jitendraphand/agrobot/docs/img/blender_anim_frame.jpg

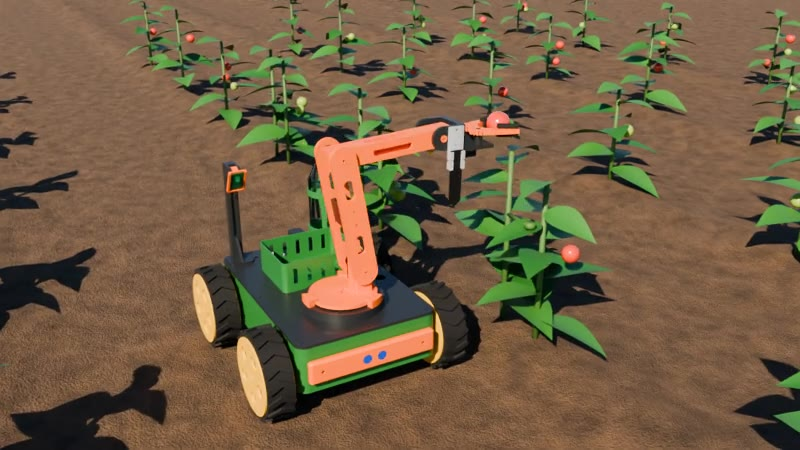
docs/img/blender_anim_frame.jpg
