jitendraphand/agrobot/simulation/assets/soil.png

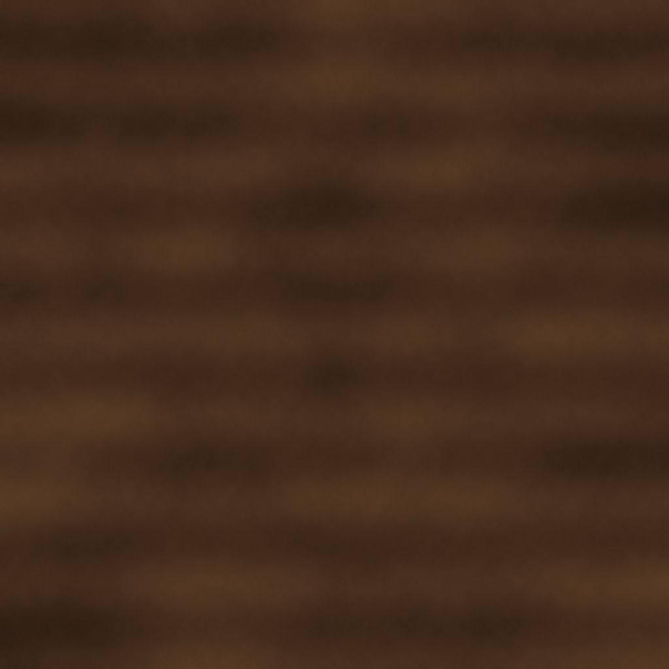
simulation/assets/soil.png
