jitendraphand/agrobot/cad/export/agrobot_assembly.step

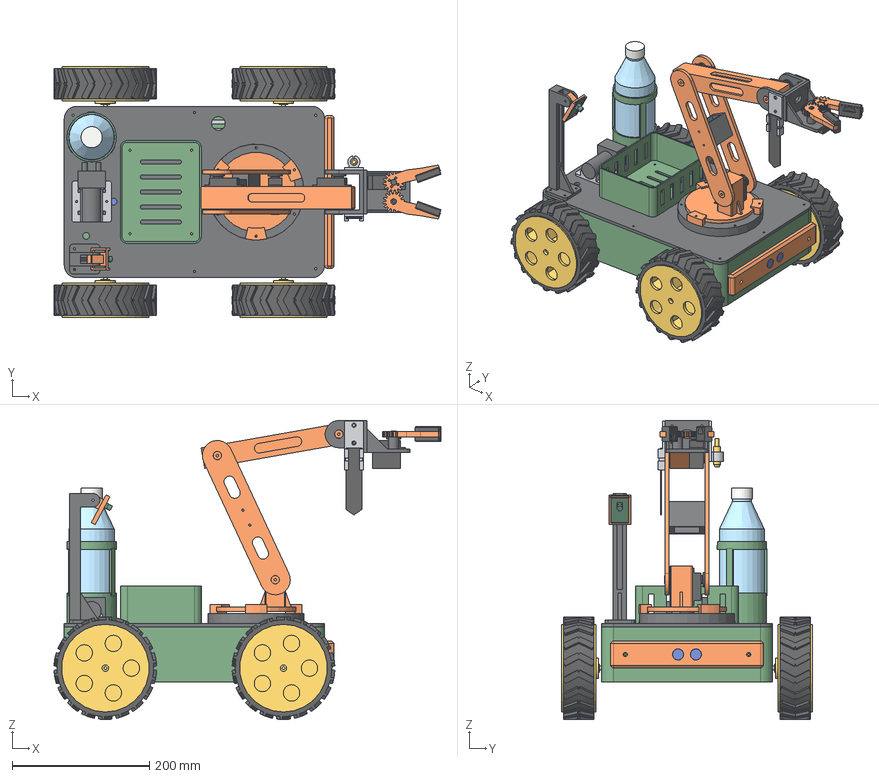
[picture p7: CAD file, 2026-11-11]
cad/export/agrobot_assembly.step
564.8 x 366.0 x 436.5 mm
chassis_tray
top_deck
electronics_plate
battery_clamp
front_bumper
wheel_rim_1 x 4
wheel_tyre_1 x 4
race_ring
turntable_clip_1 x 3
turntable
upper_arm_drive_plate
upper_arm_idler_plate
upper_arm_brace
forearm
wrist_fork
gripper_palm
finger_drive
finger_idle
finger_pad_1 x 2
probe_clip
nozzle_clip
harvest_basket
camera_mast
camera_holder
bottle_holder
pump_saddle
servo_std_1 x 5
gearmotor_1 x 4
hex_coupler_1 x 4
battery_3s
bottle_500ml
bottle_cap
pump_r385
hcsr04
esp32cam
soil_probe
spray_nozzle
esp32_devkit
pca9685
bts7960_left
bts7960_right
buck_5v_lm2596
buck_servo_xl4016
mosfet_pump
mpu6050
fuse_holder
