jitendraphand/agrobot/cad/export/step/gripper_palm.step

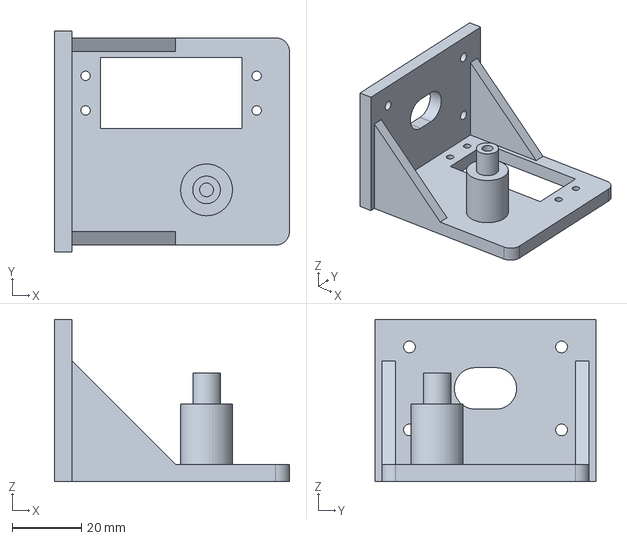
[picture p8: CAD file, 2026-11-11]
cad/export/step/gripper_palm.step
68.0 x 64.0 x 47.0 mm
