jitendraphand/agrobot/cad/export/vitamins/soil_probe.stl

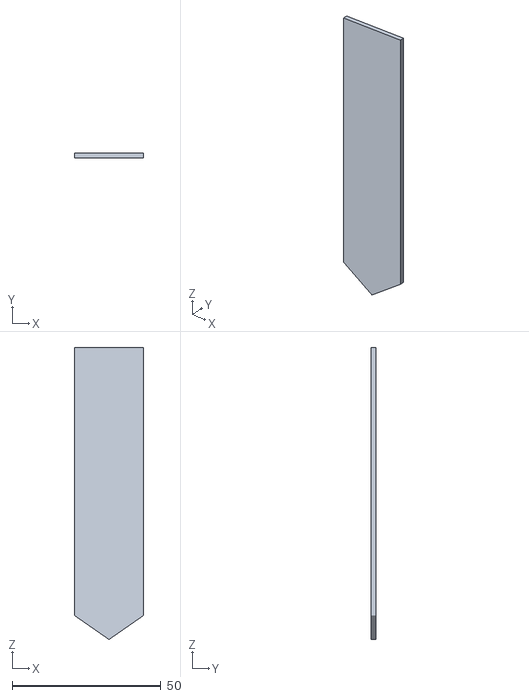
[picture p9: CAD file, 2026-11-11]
cad/export/vitamins/soil_probe.stl
23.0 x 1.60 x 98.0
