jitendraphand/agrobot/cad/export/step/camera_holder.step

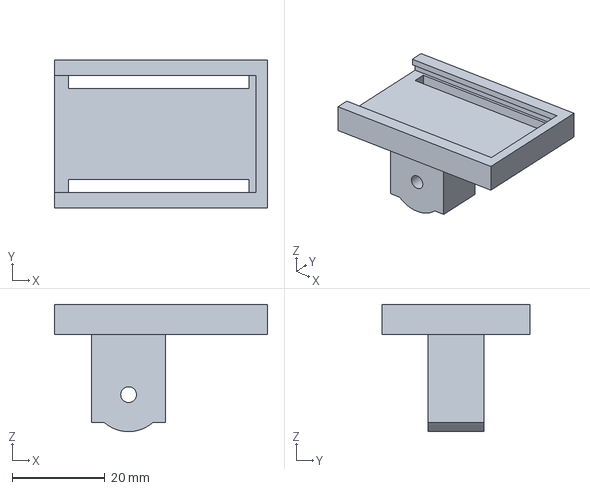
[picture p10: CAD file, 2026-11-11]
cad/export/step/camera_holder.step
46.0 x 32.0 x 27.5 mm
