jitendraphand/agrobot/cad/export/vitamins/mosfet_pump.stl

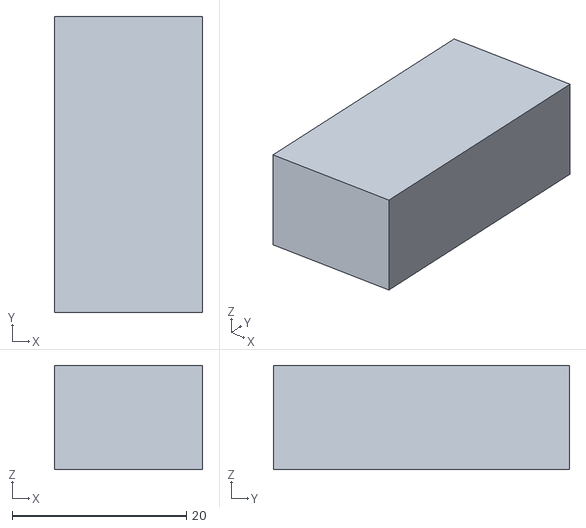
[picture p11: CAD file, 2026-11-11]
cad/export/vitamins/mosfet_pump.stl
17.0 x 34.0 x 12.0
