jitendraphand/agrobot/cad/export/step/harvest_basket.step

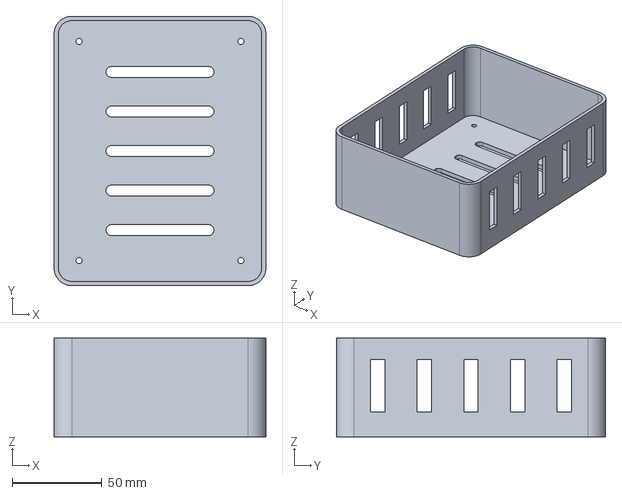
[picture p12: CAD file, 2026-11-11]
cad/export/step/harvest_basket.step
118.0 x 150.0 x 55.0 mm
