jitendraphand/agrobot/cad/export/vitamins/buck_servo_xl4016.stl

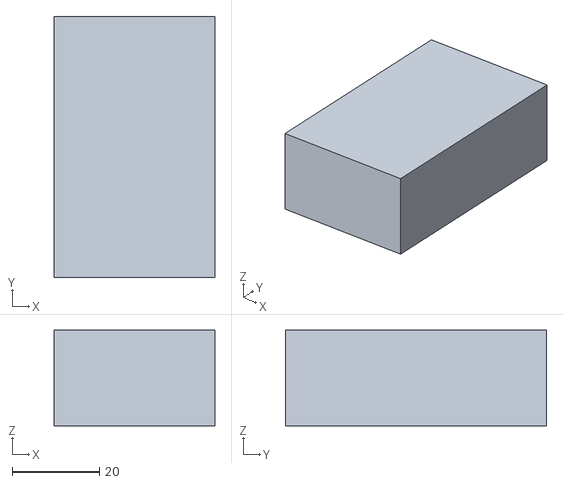
[picture p13: CAD file, 2026-11-11]
cad/export/vitamins/buck_servo_xl4016.stl
37.0 x 60.0 x 22.0
