jitendraphand/agrobot/cad/export/step/wrist_fork.step

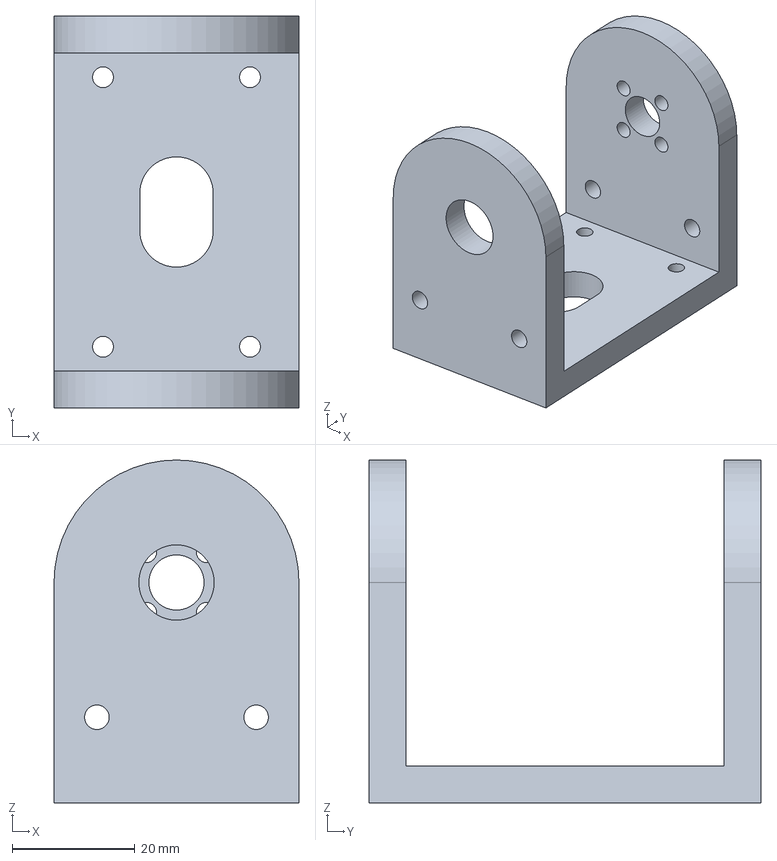
[picture p14: CAD file, 2026-11-11]
cad/export/step/wrist_fork.step
40.0 x 64.0 x 56.0 mm
