jitendraphand/agrobot/cad/export/vitamins/bts7960_left.stl

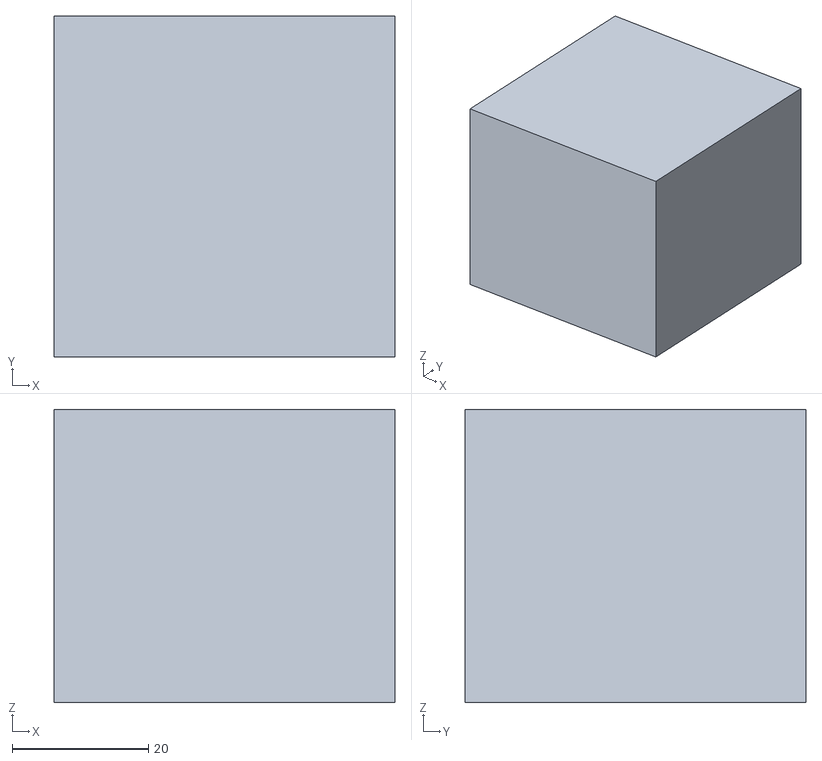
[picture p15: CAD file, 2026-11-11]
cad/export/vitamins/bts7960_left.stl
50.0 x 50.0 x 43.0
