jitendraphand/agrobot/cad/export/step/pump_saddle.step

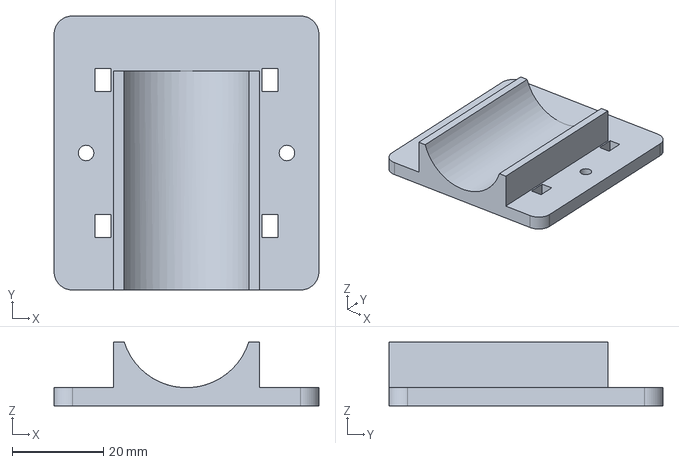
[picture p16: CAD file, 2026-11-11]
cad/export/step/pump_saddle.step
58.0 x 60.0 x 14.0 mm
