jitendraphand/agrobot/cad/export/vitamins/bottle_500ml.stl

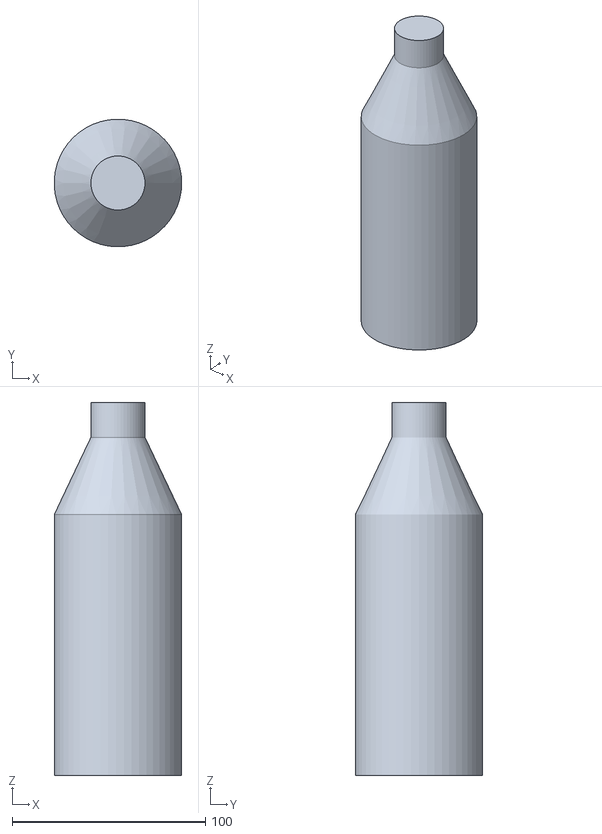
[picture p17: CAD file, 2026-11-11]
cad/export/vitamins/bottle_500ml.stl
65.9 x 66.0 x 193.0
