jitendraphand/agrobot/cad/export/step/camera_mast.step

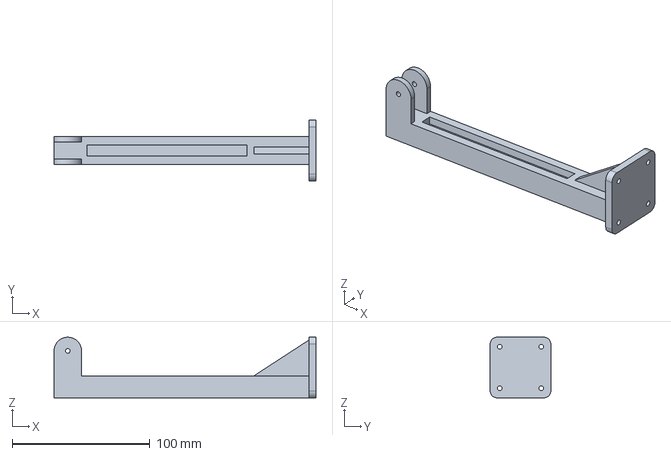
[picture p18: CAD file, 2026-11-11]
cad/export/step/camera_mast.step
190.0 x 44.0 x 44.0 mm
