jitendraphand/agrobot/cad/export/vitamins/esp32_devkit.stl

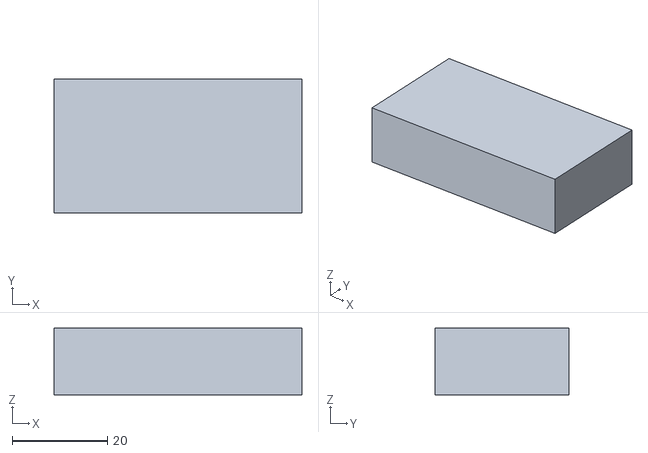
[picture p19: CAD file, 2026-11-11]
cad/export/vitamins/esp32_devkit.stl
52.0 x 28.0 x 14.0
