jitendraphand/agrobot/cad/export/step/forearm.step

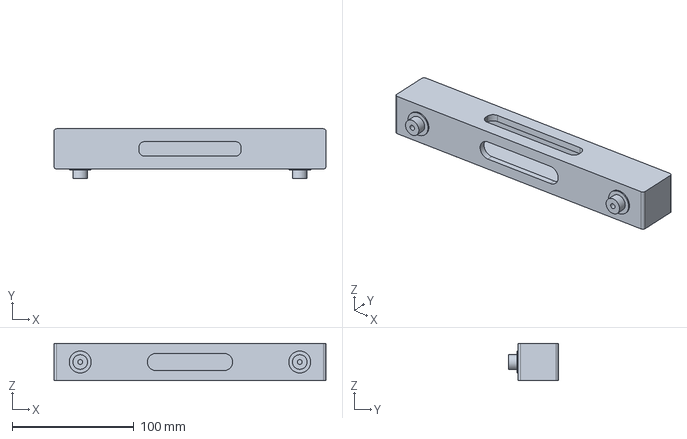
[picture p20: CAD file, 2026-11-11]
cad/export/step/forearm.step
223.0 x 40.6 x 30.4 mm
