jitendraphand/agrobot/cad/export/vitamins/pca9685.stl

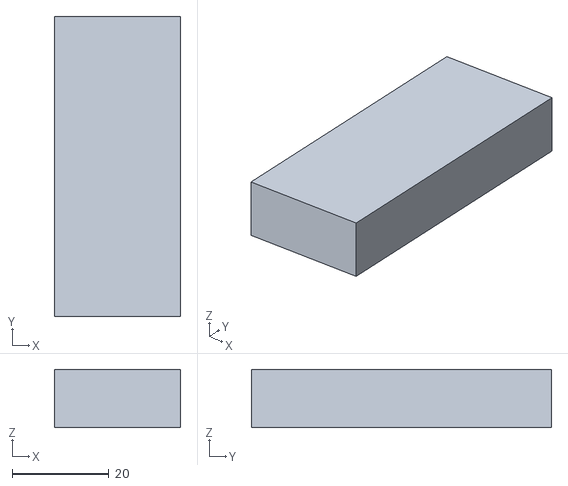
[picture p21: CAD file, 2026-11-11]
cad/export/vitamins/pca9685.stl
26.0 x 62.0 x 12.0
