jitendraphand/agrobot/cad/export/step/chassis_tray.step

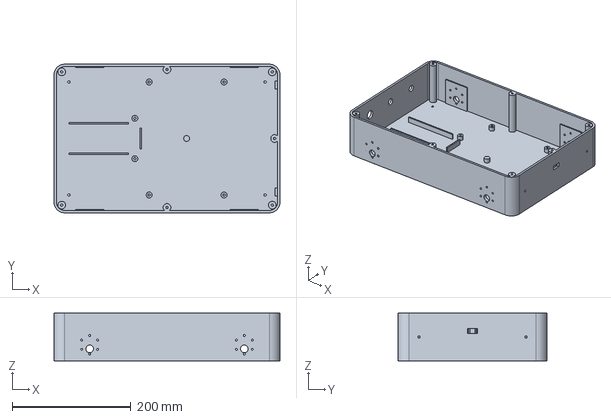
[picture p22: CAD file, 2026-11-11]
cad/export/step/chassis_tray.step
380.0 x 250.0 x 80.0 mm
