jitendraphand/agrobot/cad/export/vitamins/bottle_cap.stl

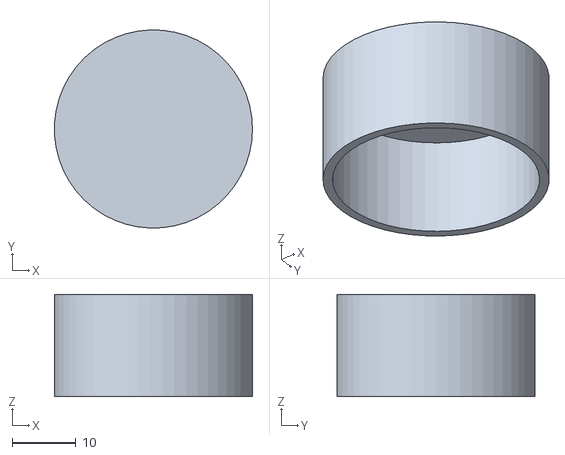
[picture p23: CAD file, 2026-11-11]
cad/export/vitamins/bottle_cap.stl
31.0 x 31.0 x 16.0
