jitendraphand/agrobot/cad/export/step/finger_drive.step

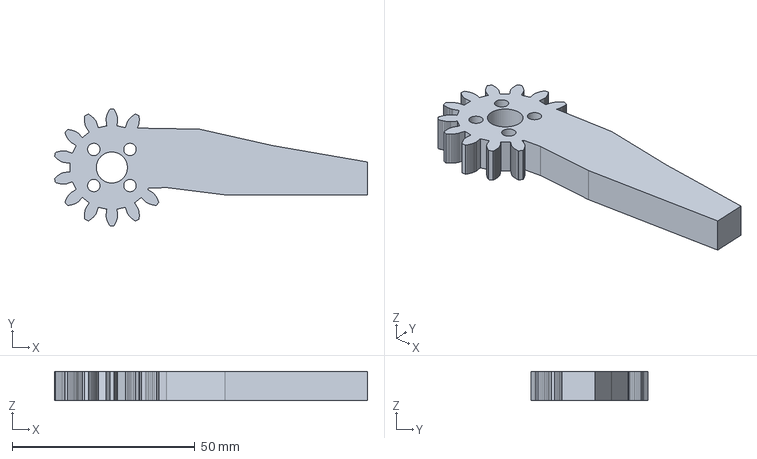
[picture p24: CAD file, 2026-11-11]
cad/export/step/finger_drive.step
85.7 x 32.0 x 8.00 mm
