jitendraphand/agrobot/cad/export/vitamins/race_balls.stl

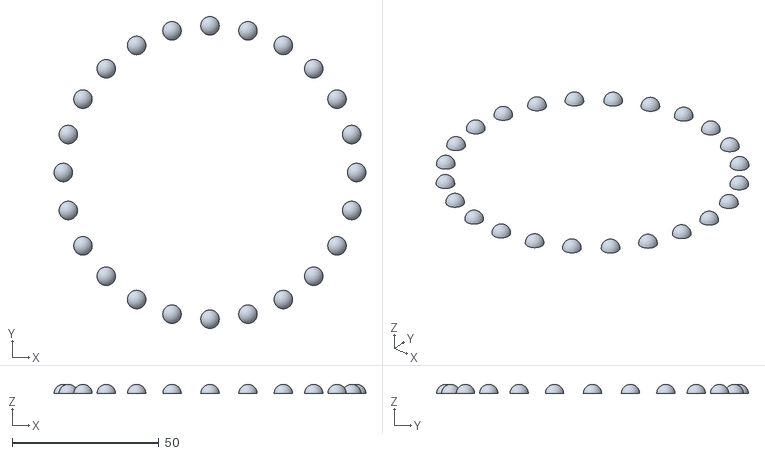
[picture p25: CAD file, 2026-11-11]
cad/export/vitamins/race_balls.stl
106.3 x 106.3 x 3.17
