jitendraphand/agrobot/cad/export/step/nozzle_clip.step

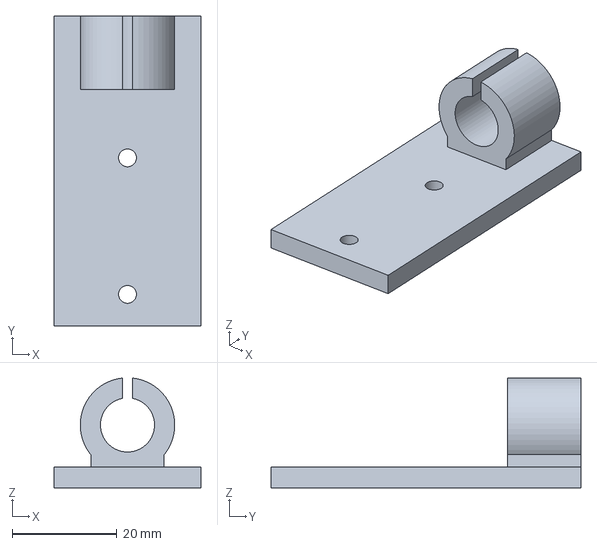
[picture p26: CAD file, 2026-11-11]
cad/export/step/nozzle_clip.step
28.0 x 59.0 x 20.9 mm
