jitendraphand/agrobot/cad/export/vitamins/gearmotor.stl

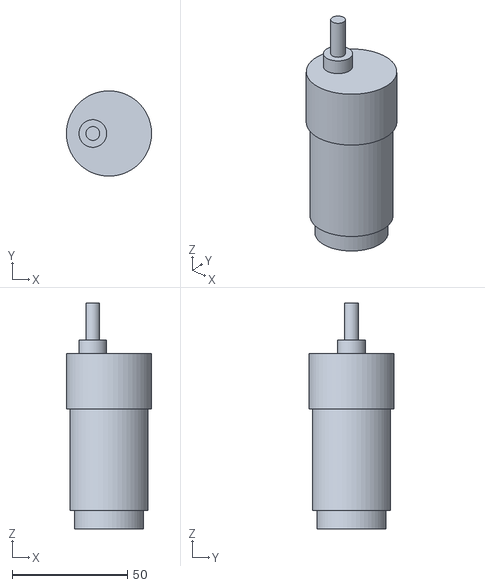
[picture p27: CAD file, 2026-11-11]
cad/export/vitamins/gearmotor.stl
37.0 x 37.0 x 98.0
