jitendraphand/agrobot/cad/export/step/upper_arm_idler_plate.step

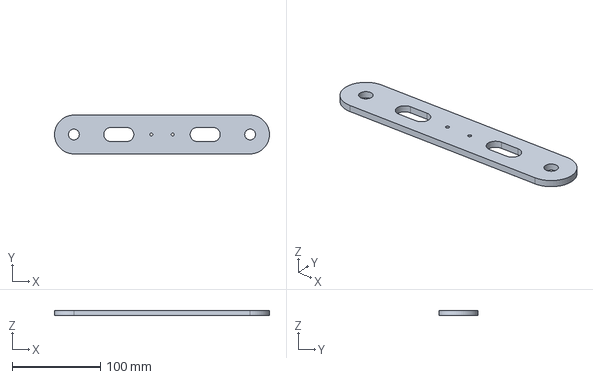
[picture p28: CAD file, 2026-11-11]
cad/export/step/upper_arm_idler_plate.step
244.0 x 44.0 x 6.00 mm
