jitendraphand/agrobot/cad/export/vitamins/hex_coupler.stl

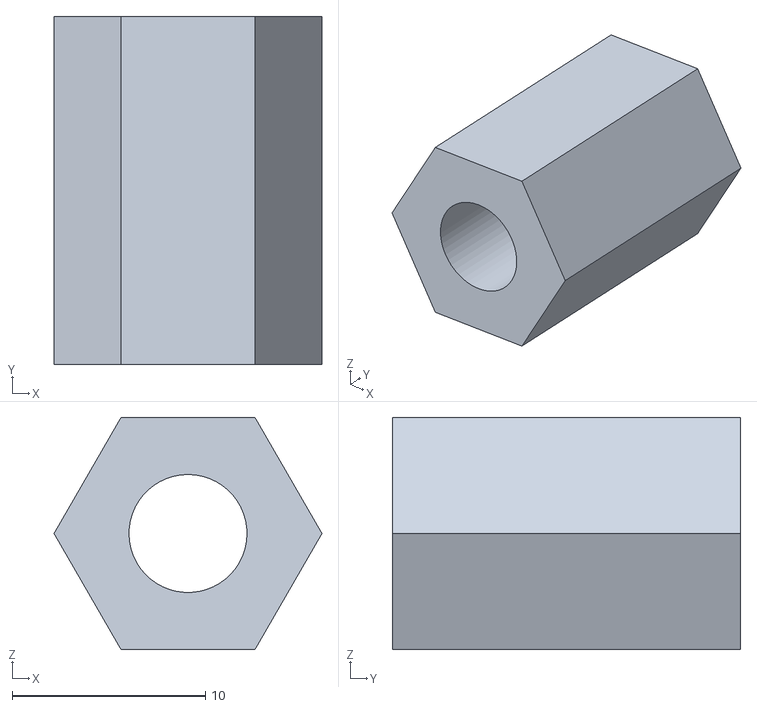
[picture p29: CAD file, 2026-11-11]
cad/export/vitamins/hex_coupler.stl
13.9 x 18.0 x 12.0
