jitendraphand/agrobot/cad/export/step/front_bumper.step

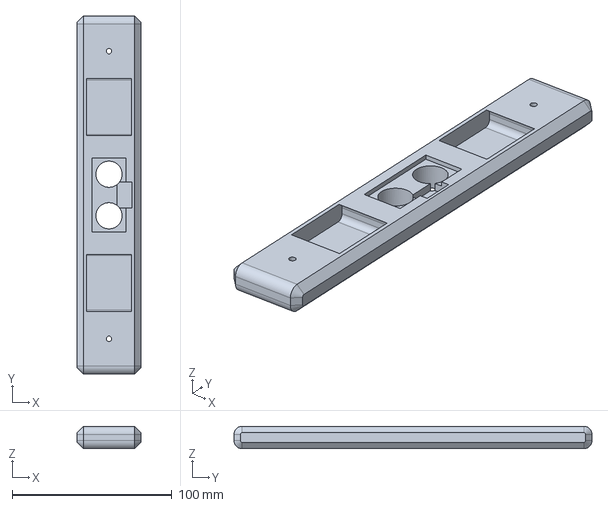
[picture p30: CAD file, 2026-11-11]
cad/export/step/front_bumper.step
40.0 x 224.0 x 14.0 mm
