jitendraphand/agrobot/cad/export/vitamins/battery_3s.stl

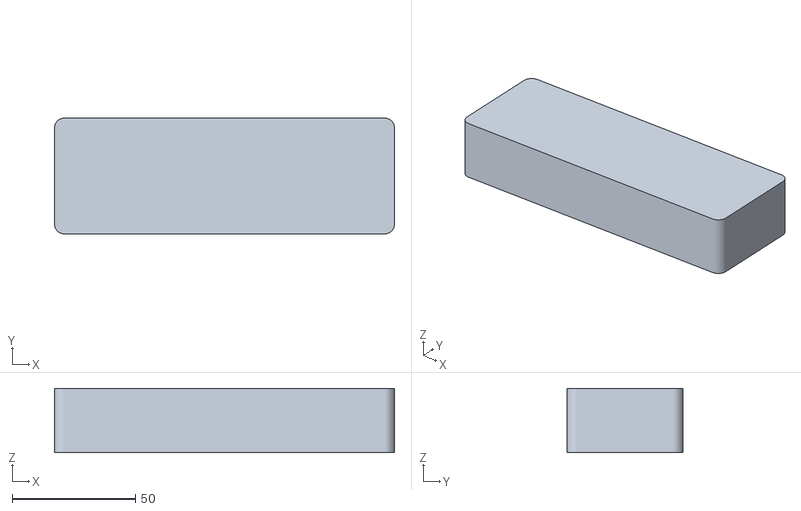
[picture p31: CAD file, 2026-11-11]
cad/export/vitamins/battery_3s.stl
138.0 x 47.0 x 26.0
