jitendraphand/agrobot/cad/export/step/wheel_rim.step

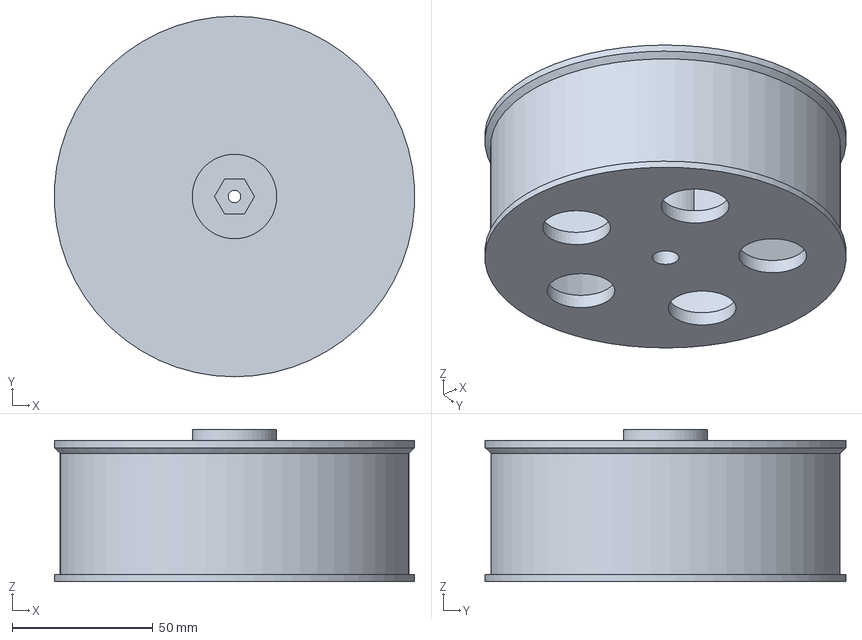
[picture p32: CAD file, 2026-11-11]
cad/export/step/wheel_rim.step
127.8 x 128.0 x 54.0 mm
