jitendraphand/agrobot/cad/export/vitamins/esp32cam.stl

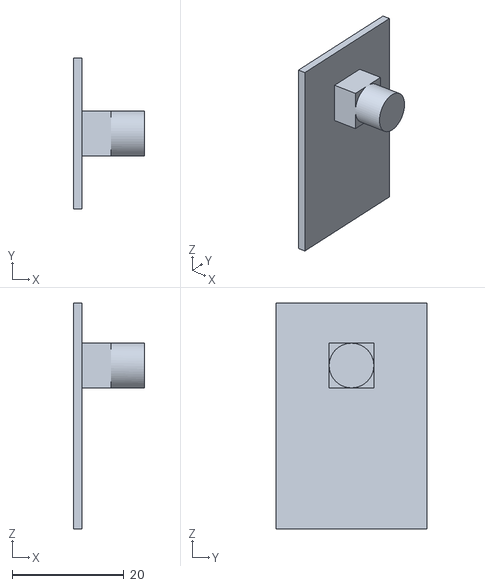
[picture p33: CAD file, 2026-11-11]
cad/export/vitamins/esp32cam.stl
12.8 x 27.0 x 40.5
