jitendraphand/agrobot/cad/export/step/finger_pad.step

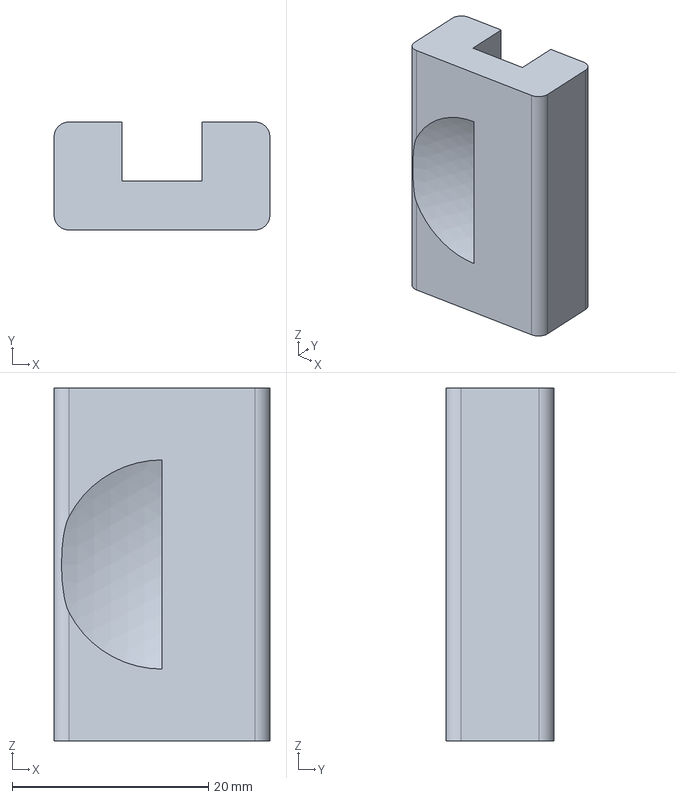
[picture p34: CAD file, 2026-11-11]
cad/export/step/finger_pad.step
22.0 x 11.0 x 36.0 mm
