jitendraphand/agrobot/cad/export/step/finger_idle.step

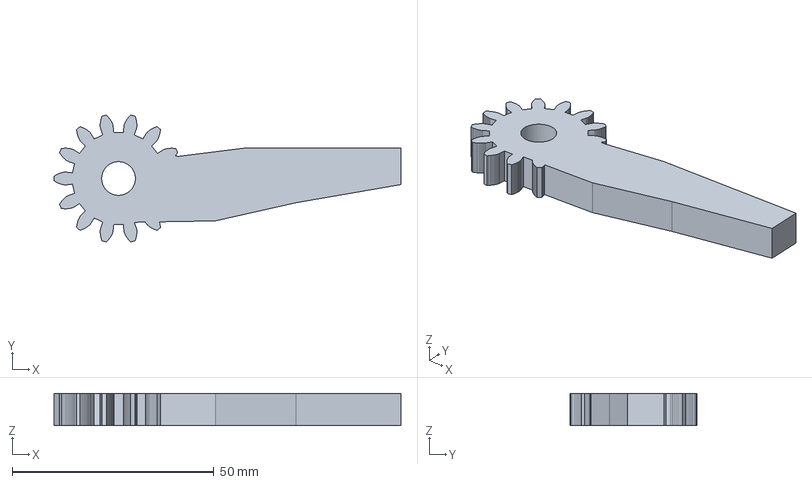
[picture p35: CAD file, 2026-11-11]
cad/export/step/finger_idle.step
86.0 x 31.4 x 8.00 mm
