jitendraphand/agrobot/cad/export/vitamins/mpu6050.stl

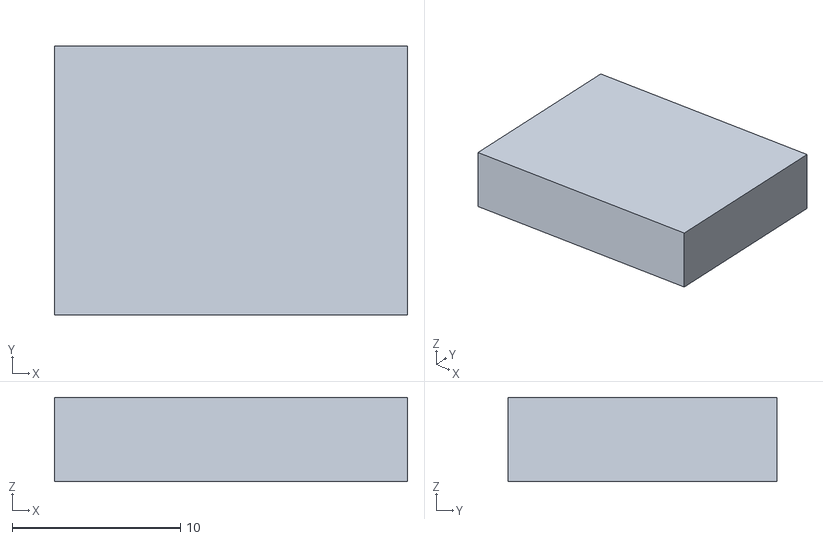
[picture p36: CAD file, 2026-11-11]
cad/export/vitamins/mpu6050.stl
21.0 x 16.0 x 5.00
