jitendraphand/agrobot/cad/export/step/probe_clip.step

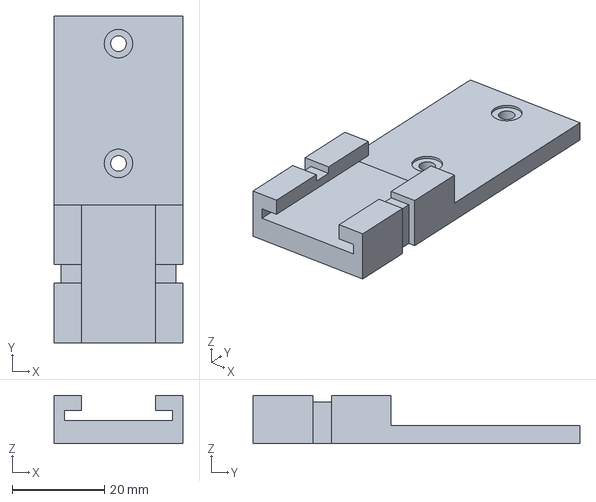
[picture p37: CAD file, 2026-11-11]
cad/export/step/probe_clip.step
28.0 x 71.0 x 10.5 mm
