jitendraphand/agrobot/cad/export/vitamins/spray_nozzle.stl

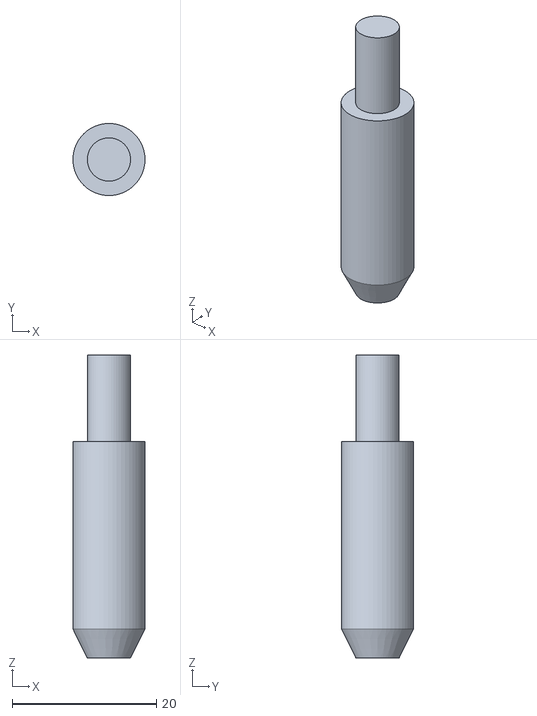
[picture p38: CAD file, 2026-11-11]
cad/export/vitamins/spray_nozzle.stl
9.99 x 10.00 x 42.0
