jitendraphand/agrobot/cad/export/vitamins/fuse_holder.stl

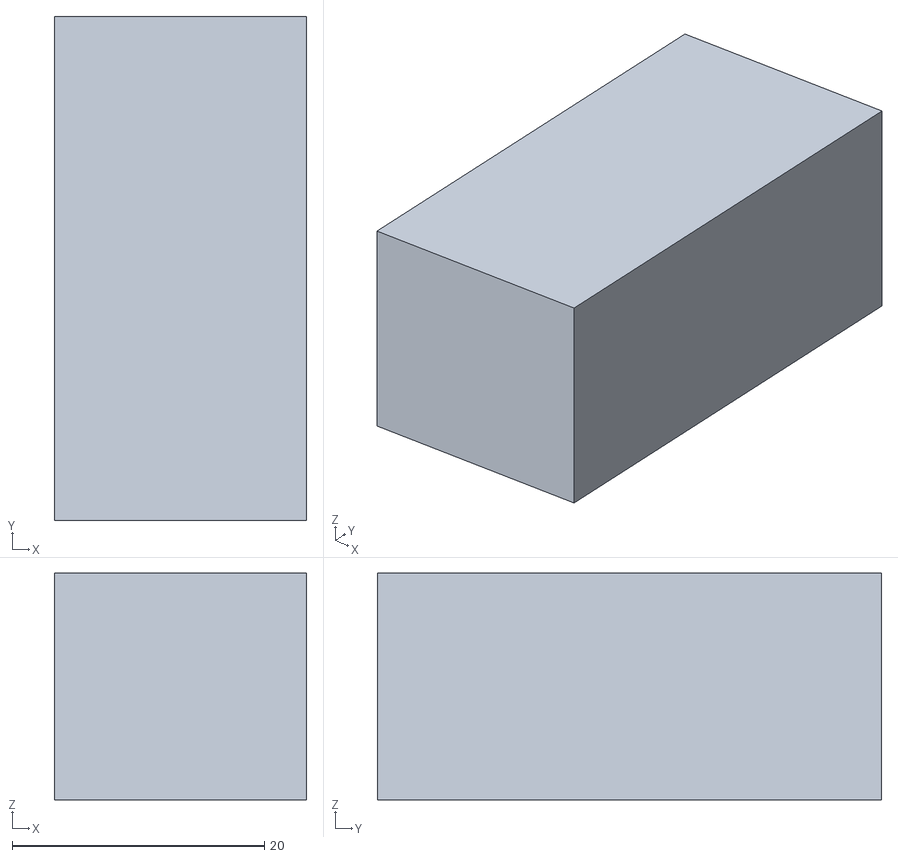
[picture p39: CAD file, 2026-11-11]
cad/export/vitamins/fuse_holder.stl
20.0 x 40.0 x 18.0
