jitendraphand/agrobot/cad/export/step/race_ring.step

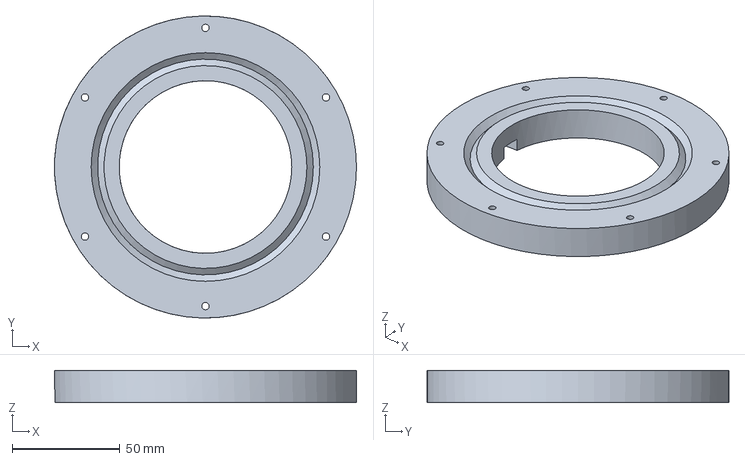
[picture p40: CAD file, 2026-11-11]
cad/export/step/race_ring.step
140.0 x 140.0 x 15.0 mm
