jitendraphand/agrobot/cad/export/vitamins/hcsr04.stl

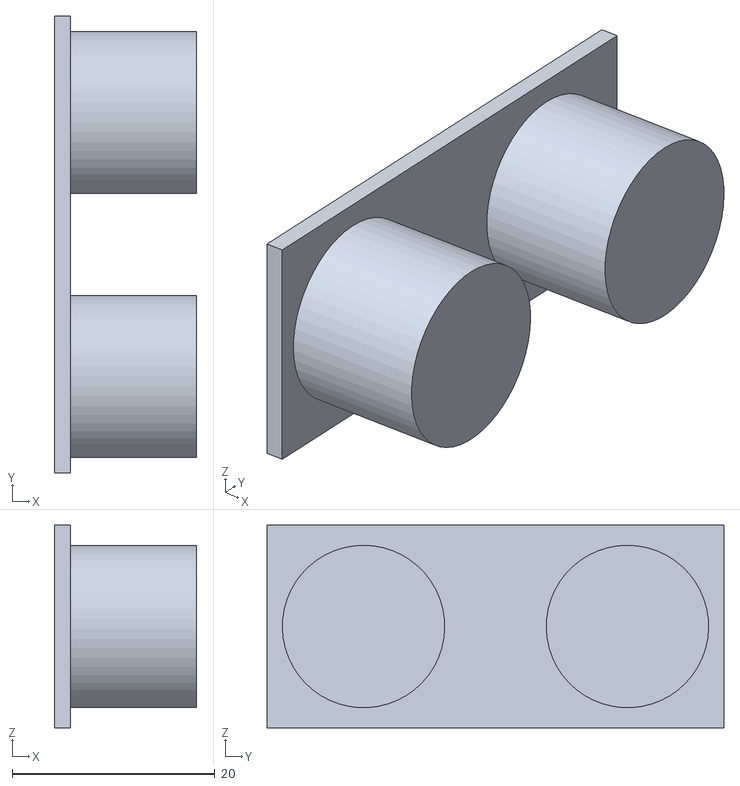
[picture p41: CAD file, 2026-11-11]
cad/export/vitamins/hcsr04.stl
14.0 x 45.0 x 20.0
