jitendraphand/agrobot/cad/export/step/battery_clamp.step

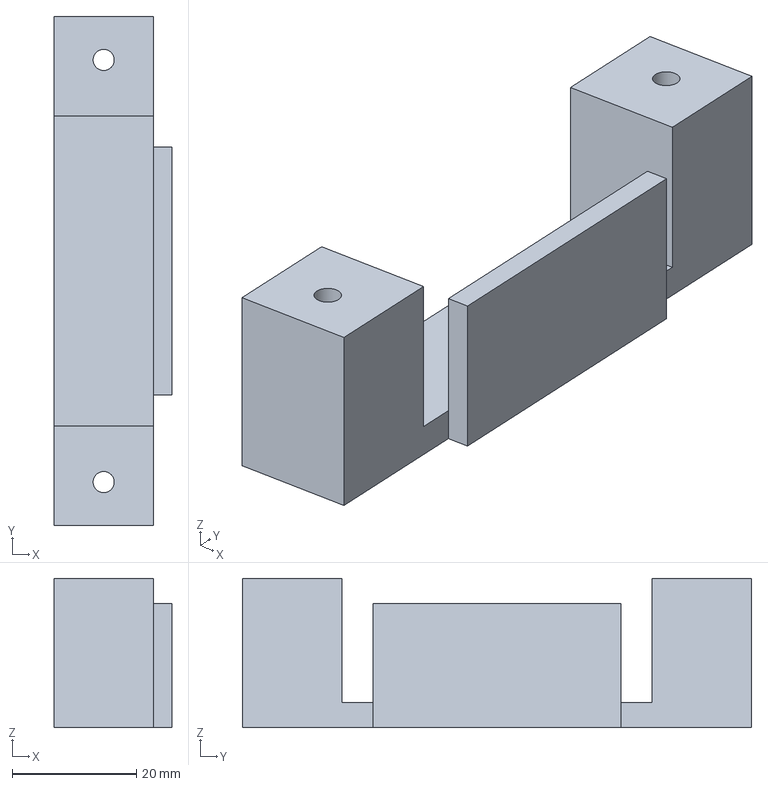
[picture p42: CAD file, 2026-11-11]
cad/export/step/battery_clamp.step
19.0 x 82.0 x 24.0 mm
