jitendraphand/agrobot/cad/export/vitamins/servo_std.stl

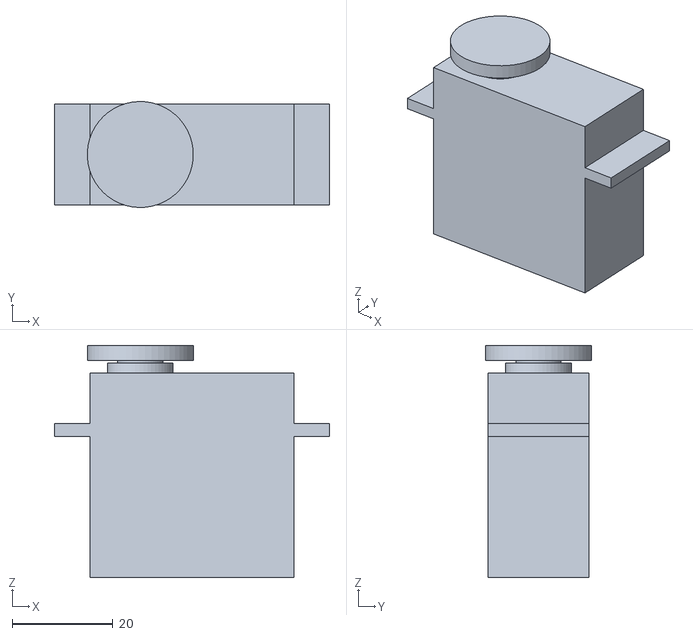
[picture p43: CAD file, 2026-11-11]
cad/export/vitamins/servo_std.stl
54.5 x 21.0 x 46.0
