jitendraphand/agrobot/cad/export/step/electronics_plate.step

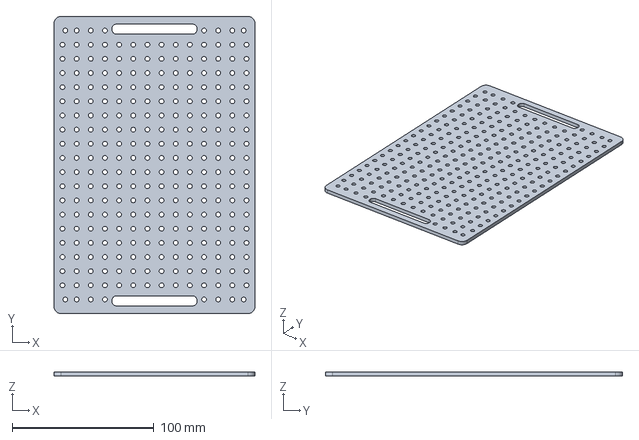
[picture p44: CAD file, 2026-11-11]
cad/export/step/electronics_plate.step
142.0 x 210.0 x 3.00 mm
