jitendraphand/agrobot/cad/export/vitamins/pump_r385.stl

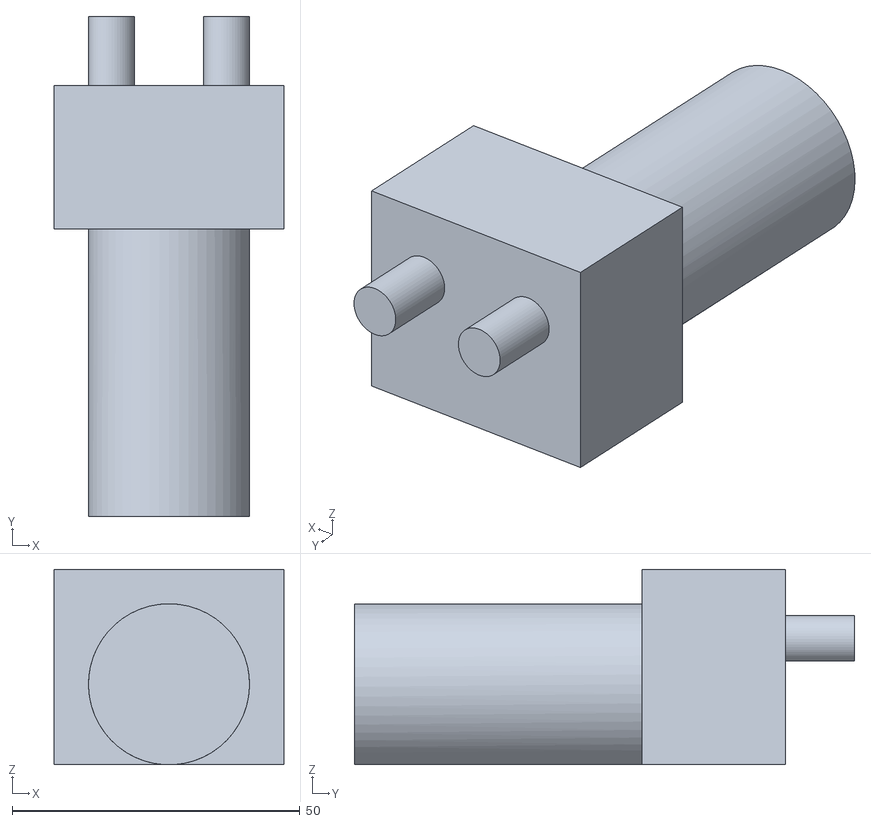
[picture p45: CAD file, 2026-11-11]
cad/export/vitamins/pump_r385.stl
40.0 x 87.0 x 34.0
