jitendraphand/agrobot/cad/export/step/turntable.step

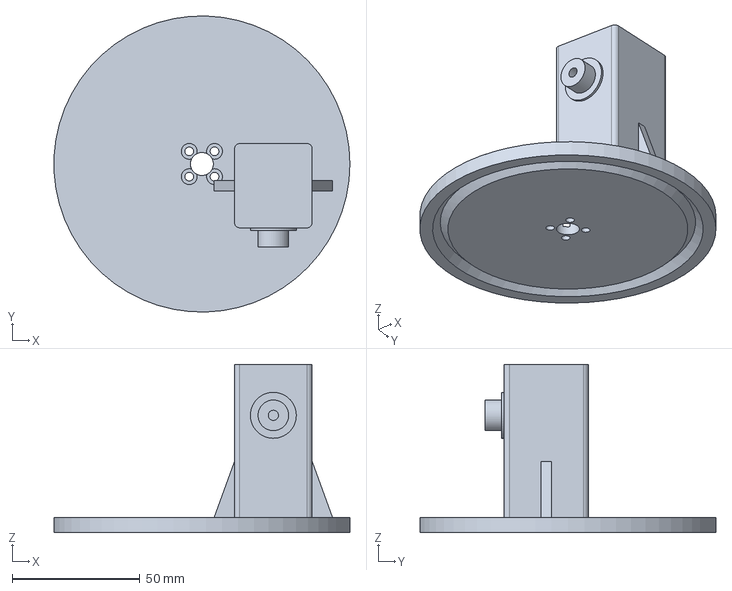
[picture p46: CAD file, 2026-11-11]
cad/export/step/turntable.step
115.9 x 116.0 x 66.0 mm
