jitendraphand/agrobot/cad/export/vitamins/buck_5v_lm2596.stl

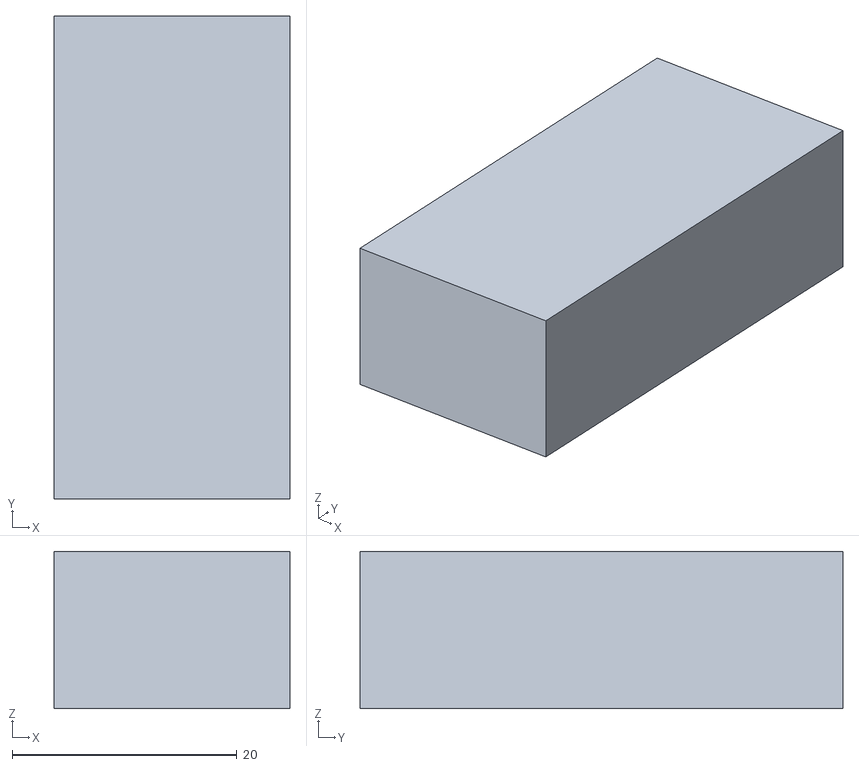
[picture p47: CAD file, 2026-11-11]
cad/export/vitamins/buck_5v_lm2596.stl
21.0 x 43.0 x 14.0
