jitendraphand/agrobot/cad/export/step/wheel_tyre.step

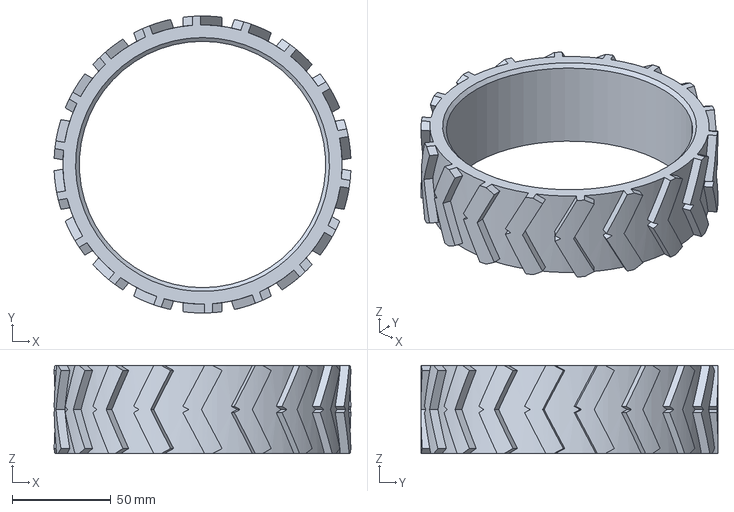
[picture p48: CAD file, 2026-11-11]
cad/export/step/wheel_tyre.step
149.9 x 150.0 x 44.6 mm
