jitendraphand/agrobot/cad/export/step/upper_arm_brace.step

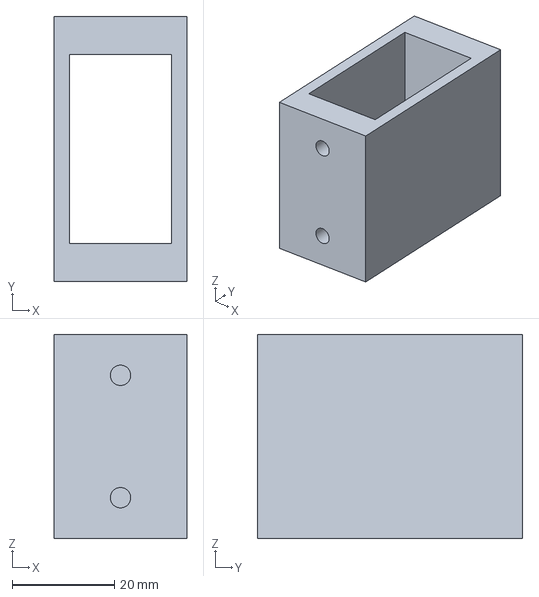
[picture p49: CAD file, 2026-11-11]
cad/export/step/upper_arm_brace.step
26.0 x 52.0 x 40.0 mm
