jitendraphand/agrobot/cad/export/step/bottle_holder.step

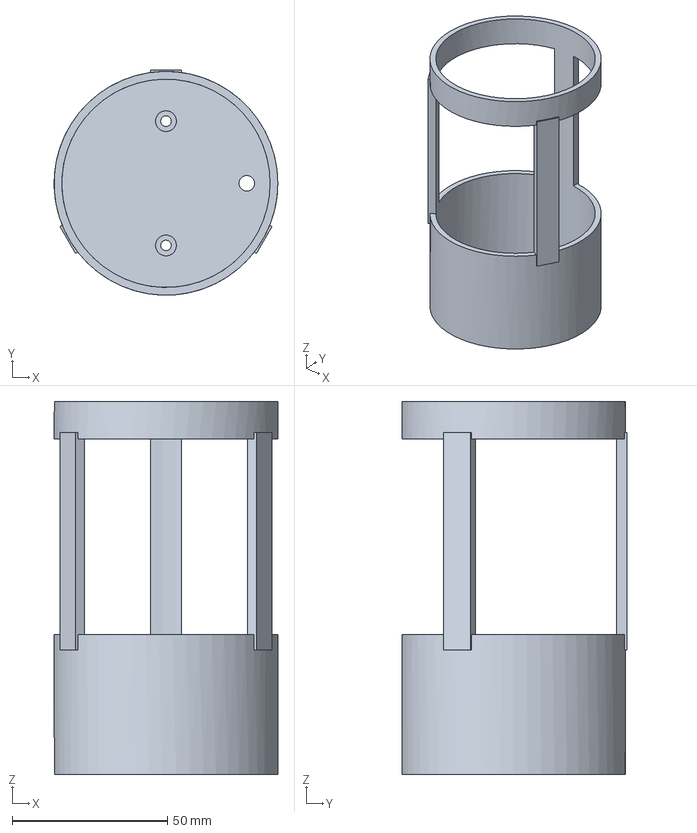
[picture p50: CAD file, 2026-11-11]
cad/export/step/bottle_holder.step
72.0 x 72.5 x 120.0 mm
