jitendraphand/agrobot/cad/export/step/top_deck.step

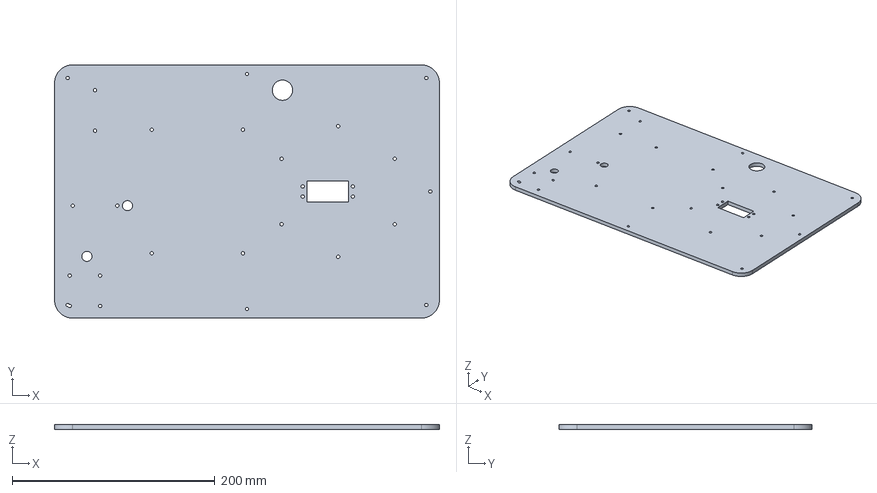
[picture p51: CAD file, 2026-11-11]
cad/export/step/top_deck.step
380.0 x 250.0 x 5.00 mm
