jitendraphand/agrobot/cad/export/step/turntable_clip.step

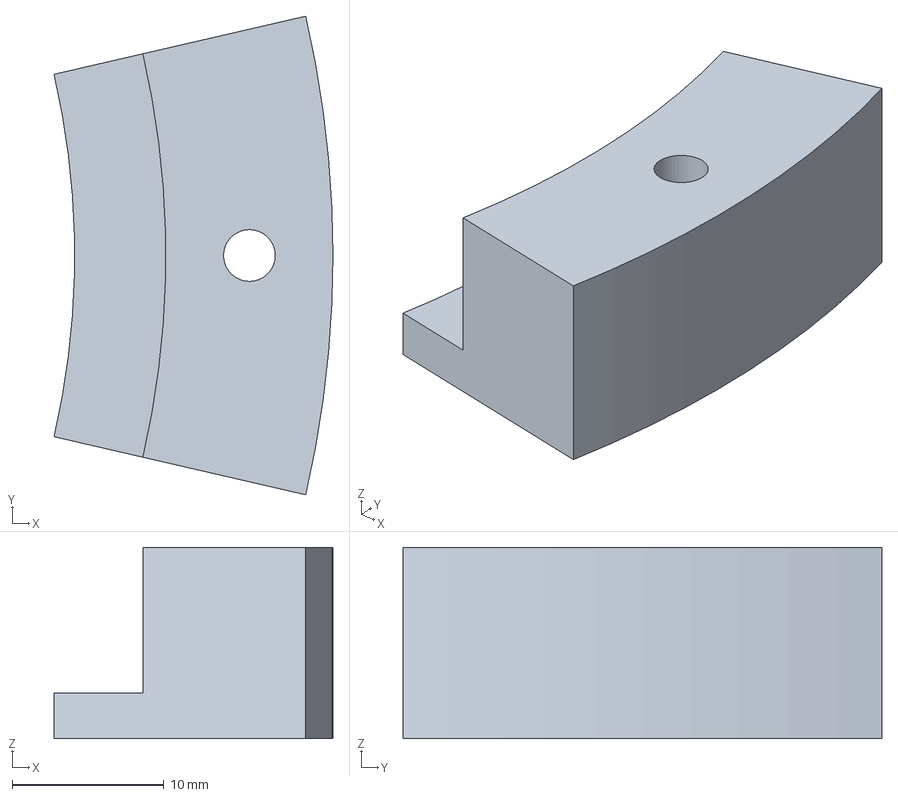
[picture p52: CAD file, 2026-11-11]
cad/export/step/turntable_clip.step
18.4 x 31.5 x 12.6 mm
