jitendraphand/agrobot/(list of files, cad)

Other CAD files:
cad/export/step/upper_arm_drive_plate.step
blender/scenes/agrobot_exploded.blend
blender/scenes/agrobot_field.blend
blender/scenes/agrobot_mission_anim.blend
blender/scenes/agrobot_studio.blend
cad/export/stl/battery_clamp.stl
cad/export/stl/bottle_holder.stl
cad/export/stl/camera_holder.stl
cad/export/stl/camera_mast.stl
cad/export/stl/chassis_tray.stl
cad/export/stl/electronics_plate.stl
cad/export/stl/finger_drive.stl
cad/export/stl/finger_idle.stl
cad/export/stl/finger_pad.stl
cad/export/stl/forearm.stl
cad/export/stl/front_bumper.stl
cad/export/stl/gripper_palm.stl
cad/export/stl/harvest_basket.stl
cad/export/stl/nozzle_clip.stl
cad/export/stl/probe_clip.stl
cad/export/stl/pump_saddle.stl
cad/export/stl/race_ring.stl
cad/export/stl/top_deck.stl
cad/export/stl/turntable.stl
cad/export/stl/turntable_clip.stl
cad/export/stl/upper_arm_brace.stl
cad/export/stl/upper_arm_drive_plate.stl
cad/export/stl/upper_arm_idler_plate.stl
cad/export/stl/wheel_rim.stl
cad/export/stl/wheel_tyre.stl
cad/export/stl/wrist_fork.stl
