jitendraphand/agrobot/cad/export/print_report.md

# Print report - Elegoo Neptune 4 Max

Build volume 420 x 420 x 480 mm; checked against 400 x 400 x 470 mm (10 mm margin). Files are exported in print orientation.

Mass = solid volume x density x 0.55 (4 perimeters + ~25 % infill). Treat it as an estimate; your slicer has the real number.

| Part | Qty | Material | X x Y x Z (mm) | Est. mass each (g) | Fits | Notes |
|---|---|---|---|---|---|---|
| `chassis_tray` | 1 | PETG | 380 x 250 x 80 | 587 | yes | Main tub. 4 perimeters, 25 % infill, no supports. |
| `top_deck` | 1 | PETG | 380 x 250 x 5 | 325 | yes | Lid / arm deck. Print flat, 5 perimeters. |
| `electronics_plate` | 1 | PETG | 142 x 210 x 3 | 56 | yes | 10 mm M3 grid for standoffs / zip ties. |
| `battery_clamp` | 1 | PETG | 19 x 82 x 24 | 12 | yes | Printed upside down (open side up). |
| `front_bumper` | 1 | PETG | 40 x 224 x 14 | 62 | yes | Front face on the bed. Houses the HC-SR04. |
| `wheel_rim` | 4 | PETG | 128 x 128 x 54 | 168 | yes | Outboard face on the bed. 5 perimeters, 40 % infill. |
| `wheel_tyre` | 4 | TPU 95A | 150 x 150 x 45 | 126 | yes | TPU 95A, 3 perimeters, 15 % infill. PETG works on hard floors. |
| `race_ring` | 1 | PETG | 140 x 140 x 15 | 105 | yes | Lower ball race. 0.12-0.16 mm layers for a smooth groove. |
| `turntable_clip` | 3 | PETG | 18 x 31 x 13 | 3 | yes | Printed lip-down. 100 % infill. |
| `turntable` | 1 | PETG | 116 x 116 x 66 | 67 | yes | Disc on the bed. Support only under the journal boss. |
| `upper_arm_drive_plate` | 1 | PETG | 244 x 44 x 6 | 38 | yes | Flat. 6 perimeters (effectively solid). |
| `upper_arm_idler_plate` | 1 | PETG | 244 x 44 x 6 | 38 | yes | Flat. 6 perimeters (effectively solid). |
| `upper_arm_brace` | 1 | PETG | 26 x 52 x 40 | 17 | yes | Duct axis vertical. |
| `forearm` | 1 | PETG | 223 x 41 x 30 | 73 | yes | As modelled (bottom wall on bed). Support only under the two journal bosses. |
| `wrist_fork` | 1 | PETG | 40 x 64 x 56 | 24 | yes | Web on the bed, arms pointing up. |
| `gripper_palm` | 1 | PETG | 68 x 64 x 47 | 25 | yes | Plate on the bed. |
| `finger_drive` | 1 | PETG | 86 x 32 x 8 | 7 | yes | Flat, 100 % infill, 0.12 mm layers for clean gear teeth. |
| `finger_idle` | 1 | PETG | 86 x 31 x 8 | 7 | yes | Flat, 100 % infill, 0.12 mm layers for clean gear teeth. |
| `finger_pad` | 2 | TPU 95A | 22 x 11 x 36 | 4 | yes | TPU 95A, standing on end, 100 % infill. Press on, add a drop of CA glue. |
| `probe_clip` | 1 | PETG | 28 x 71 x 11 | 7 | yes | Back face on the bed. |
| `nozzle_clip` | 1 | PETG | 28 x 59 x 21 | 6 | yes | Back face on the bed. |
| `harvest_basket` | 1 | PETG | 118 x 150 x 55 | 74 | yes | Vase-like, 3 perimeters. |
| `camera_mast` | 1 | PETG | 190 x 44 x 44 | 49 | yes | Lying on its back for strength. |
| `camera_holder` | 1 | PETG | 46 x 32 x 28 | 6 | yes | Back plate on the bed. |
| `bottle_holder` | 1 | PETG | 72 x 72 x 120 | 33 | yes | Upright. |
| `pump_saddle` | 1 | PETG | 58 x 60 x 14 | 13 | yes | Flat. |

**Totals:** PETG ~2315 g, TPU ~511 g, 35 printed pieces from 26 unique files.
