jitendraphand/agrobot/docs/img/terrain_test_frame.jpg

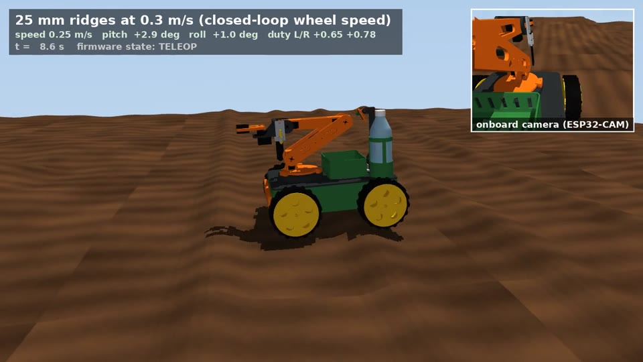
docs/img/terrain_test_frame.jpg
