jitendraphand/agrobot/firmware/esp32cam/esp32cam.ino

// AgroBot camera: AI-Thinker ESP32-CAM streaming MJPEG to the control panel.
// Set the SSID below to the robot's access point, then either open this file in
// the Arduino IDE (board "AI Thinker ESP32-CAM") or run
//   pio run -d firmware/esp32cam -t upload
// with the ESP32-CAM-MB USB board or an FTDI adapter (IO0 to GND).
// Stream:  http://<camera ip>/stream     (the first client of the AP gets 192.168.4.2)
//
// Compiled in CI (PlatformIO, board esp32cam) but not yet run on a camera module.
#include <WiFi.h>
#include <WebServer.h>
#include "esp_camera.h"

const char* WIFI_SSID = "AgroBot-XXXX";      // printed by the robot on its serial port at boot
const char* WIFI_PASS = "agrobot123";

// AI-Thinker ESP32-CAM pin map
#define PWDN_GPIO_NUM 32
#define RESET_GPIO_NUM -1
#define XCLK_GPIO_NUM 0
#define SIOD_GPIO_NUM 26
#define SIOC_GPIO_NUM 27
#define Y9_GPIO_NUM 35
#define Y8_GPIO_NUM 34
#define Y7_GPIO_NUM 39
#define Y6_GPIO_NUM 36
#define Y5_GPIO_NUM 21
#define Y4_GPIO_NUM 19
#define Y3_GPIO_NUM 18
#define Y2_GPIO_NUM 5
#define VSYNC_GPIO_NUM 25
#define HREF_GPIO_NUM 23
#define PCLK_GPIO_NUM 22

WebServer server(80);

void handleStream() {
  WiFiClient client = server.client();
  client.print("HTTP/1.1 200 OK\r\nContent-Type: multipart/x-mixed-replace; boundary=frame\r\n"
               "Access-Control-Allow-Origin: *\r\nCache-Control: no-cache\r\n\r\n");
  while (client.connected()) {
    camera_fb_t* fb = esp_camera_fb_get();
    if (!fb) break;
    client.printf("--frame\r\nContent-Type: image/jpeg\r\nContent-Length: %u\r\n\r\n", (unsigned)fb->len);
    client.write(fb->buf, fb->len);
    client.print("\r\n");
    esp_camera_fb_return(fb);
    delay(60);                                   // ~15 fps is plenty and keeps the WiFi link free for control
  }
}

void setup() {
  Serial.begin(115200);
  camera_config_t c = {};
  c.ledc_channel = LEDC_CHANNEL_0;
  c.ledc_timer = LEDC_TIMER_0;
  c.pin_d0 = Y2_GPIO_NUM;  c.pin_d1 = Y3_GPIO_NUM;  c.pin_d2 = Y4_GPIO_NUM;  c.pin_d3 = Y5_GPIO_NUM;
  c.pin_d4 = Y6_GPIO_NUM;  c.pin_d5 = Y7_GPIO_NUM;  c.pin_d6 = Y8_GPIO_NUM;  c.pin_d7 = Y9_GPIO_NUM;
  c.pin_xclk = XCLK_GPIO_NUM;  c.pin_pclk = PCLK_GPIO_NUM;  c.pin_vsync = VSYNC_GPIO_NUM;  c.pin_href = HREF_GPIO_NUM;
  c.pin_sccb_sda = SIOD_GPIO_NUM;  c.pin_sccb_scl = SIOC_GPIO_NUM;
  c.pin_pwdn = PWDN_GPIO_NUM;  c.pin_reset = RESET_GPIO_NUM;
  c.xclk_freq_hz = 20000000;
  c.pixel_format = PIXFORMAT_JPEG;
  c.frame_size = FRAMESIZE_VGA;
  c.jpeg_quality = 14;
  c.fb_count = 1;
  if (esp_camera_init(&c) != ESP_OK) {
    Serial.println("camera init failed");
    return;
  }
  sensor_t* s = esp_camera_sensor_get();
  s->set_vflip(s, 0);
  WiFi.mode(WIFI_STA);
  WiFi.begin(WIFI_SSID, WIFI_PASS);
  while (WiFi.status() != WL_CONNECTED) delay(250);
  Serial.printf("stream: http://%s/stream\n", WiFi.localIP().toString().c_str());
  server.on("/stream", handleStream);
  server.begin();
}

void loop() { server.handleClient(); }
