jitendraphand/agrobot/(commit log)

2026-11-11 AgroBot Mk1: parametric CAD, firmware core, MuJoCo simulation, Blender scenes (work in progress)
    Claude-Session: https://claude.ai/code/session_01XQcAi9onaY9ZEYu54StheM
    [agrobot_exploded.blend, agrobot_field.blend, agrobot_studio.blend, battery_3s.stl, battery_clamp.step, battery_clamp.stl, bottle_500ml.stl, bottle_cap.stl]
2026-11-11 Add CI (host tests, ESP32 build, CAD and simulation checks), docs and terrain scenario
    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
    [agrobot_mission_anim.blend, agrobot_studio.blend]
2026-11-11 Build the camera sketch in CI; README and Blender notes
    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
2026-11-11 CAD: fix non-manifold palm and fork meshes, add STL integrity check; first Blender renders
    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
    [agrobot_assembly.step, battery_clamp.step, bottle_holder.step, camera_holder.step, camera_mast.step, chassis_tray.step, electronics_plate.step, finger_drive.step]
2026-11-11 Exploded-view render, BOM budget corrections
    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
    [agrobot_exploded.blend, agrobot_field.blend]
2026-11-11 Wrist fork: heat-set inserts for the tool clips; correct fastener sizes in the guides
    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
    [agrobot_assembly.step, battery_clamp.step, bottle_holder.step, camera_holder.step, camera_mast.step, chassis_tray.step, electronics_plate.step, finger_drive.step]
2026-11-12 Final renders and videos, measured results in the docs
    - simulation/output: row mission and terrain videos, reports, trajectories
    - blender: mission animation (replayed from the simulation), scenes re-saved from the final CAD
    - README / docs: results tables filled from the simulation reports
    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
    [agrobot_exploded.blend, agrobot_field.blend, agrobot_mission_anim.blend, agrobot_studio.blend]
